alektor-diy/keyboard/temp/02.jpg

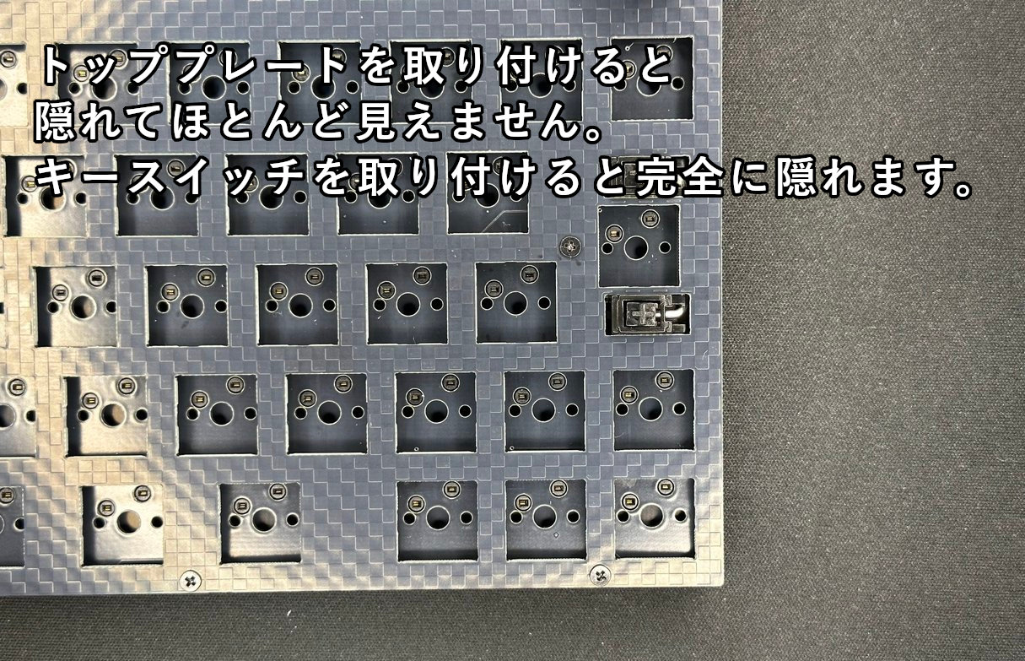
temp/02.jpg
