alektor-diy/keyboard/Maple50w/G0LdGCEbUAcLgUl.jpg

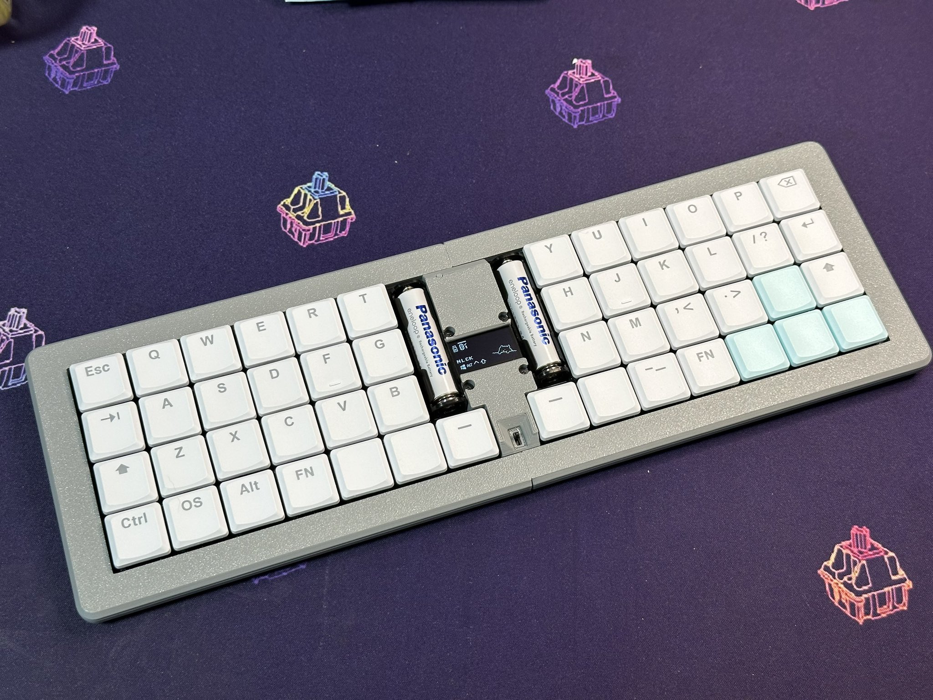
Maple50w/G0LdGCEbUAcLgUl.jpg
