alektor-diy/keyboard/temp/01.jpg

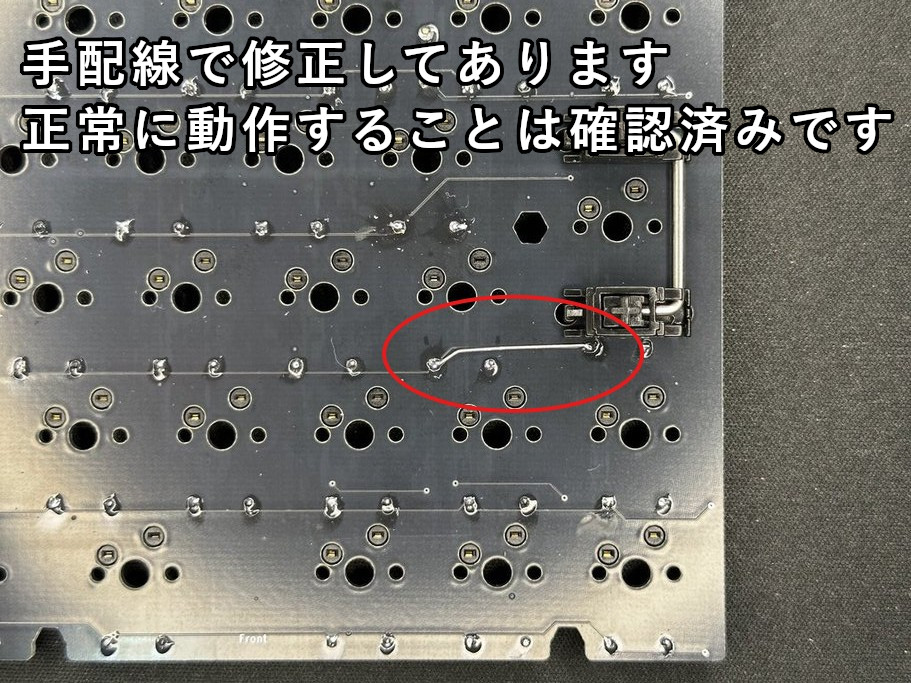
temp/01.jpg
