alektor-diy/keyboard/temp/03.jpg

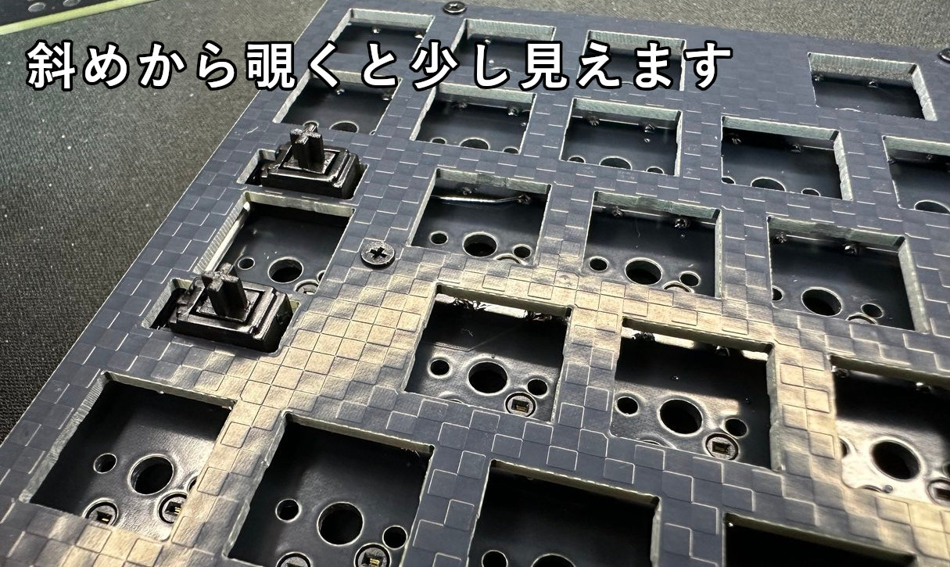
temp/03.jpg
