alektor-diy/keyboard/moon83s/pcb/Moon83s_Right_assemble.step

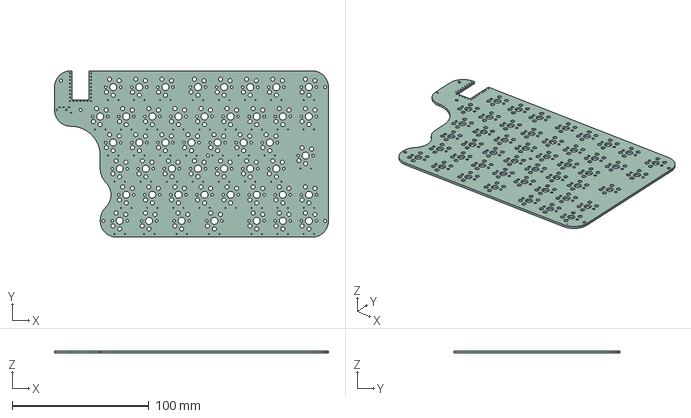
[picture p5: CAD file, 2026-04-03]
moon83s/pcb/Moon83s_Right_assemble.step
200.0 x 121.4 x 1.60 mm
