alektor-diy/keyboard/moon83s/pcb/Moon83s_Left_assemble.step

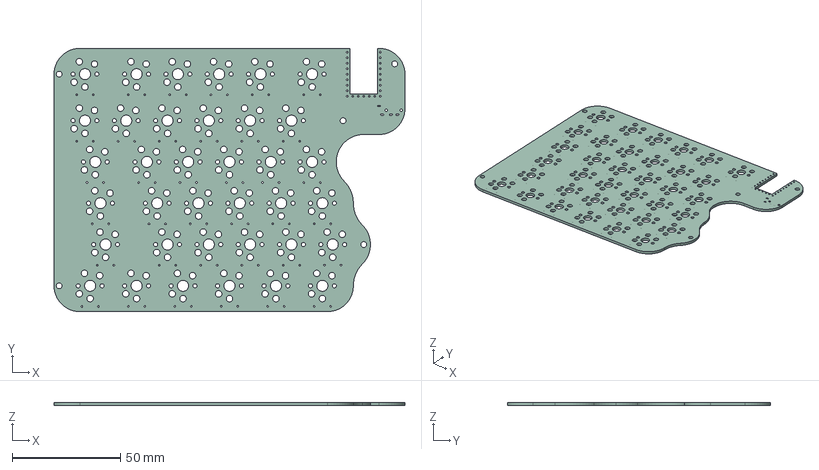
[picture p6: CAD file, 2026-04-03]
moon83s/pcb/Moon83s_Left_assemble.step
161.9 x 121.4 x 1.51 mm
