alektor-diy/keyboard/mars74g/mars74g_pcb.step

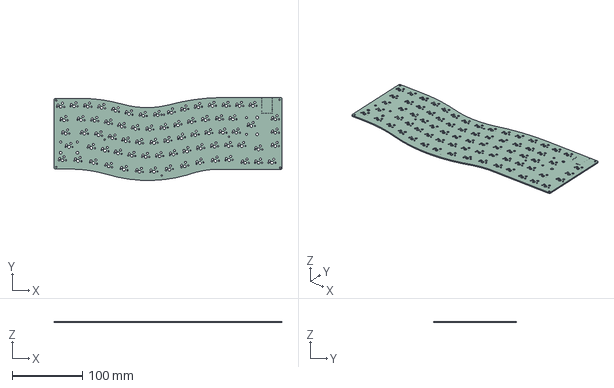
[picture p7: CAD file, 2025-04-18]
mars74g/mars74g_pcb.step
324.6 x 118.0 x 1.60 mm
