alektor-diy/keyboard/METEO2040/STEP/METEO2040.step

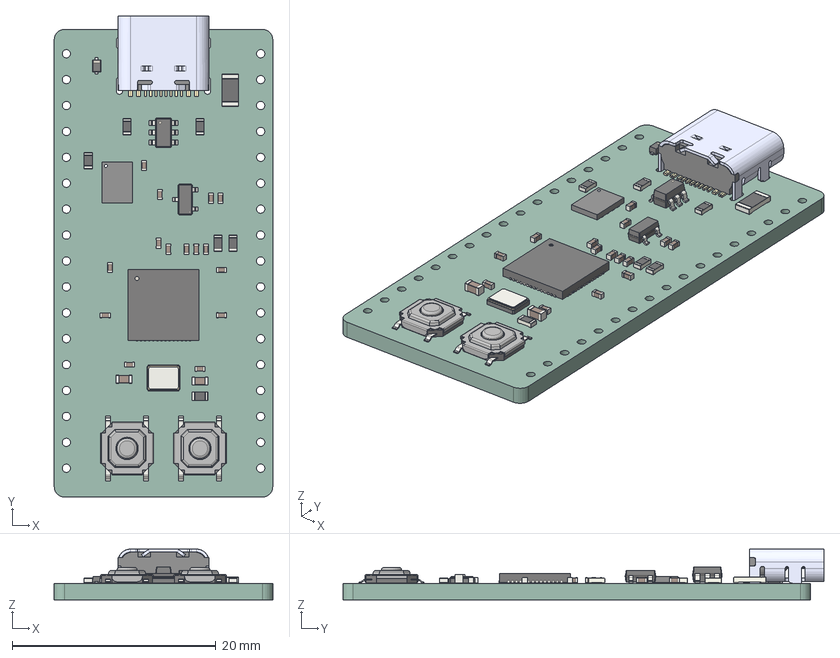
[picture p8: CAD file, 2026-06-22]
METEO2040/STEP/METEO2040.step
21.4 x 47.2 x 5.00 mm
SOT-23-3
R_0603_1608Metric x 6
C_0402_1005Metric x 15
SW_SPST_SKQG_WithStem x 2
D_SOD_523
BaseWithTopCut
TopCircle_NewBody
TYPE-C-31-M-12
Fuse_1206_3216Metric
Crystal_SMD_3225-4Pin_3.2x2.5mm
C_0603_1608Metric x 2
QFN-56-1EP_7x7mm_P0.4mm_EP3.2x3.2mm
SOT-23-6
MetD92B_PCB
