alektor-diy/keyboard/SylvaTwin/pcb/SylvaTwin_Right.step

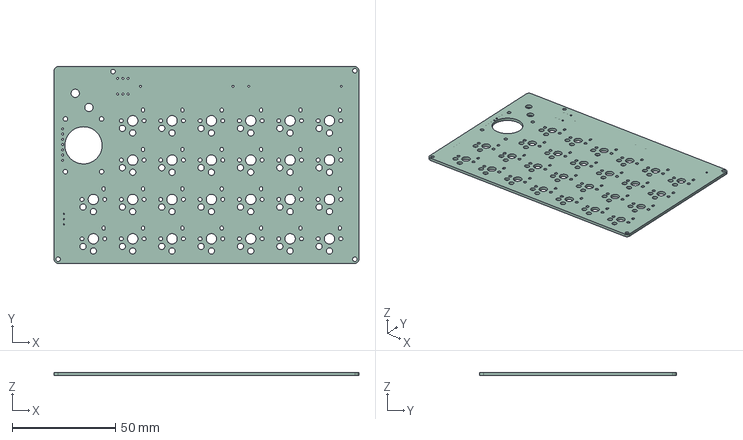
[picture p9: CAD file, 2025-12-02]
SylvaTwin/pcb/SylvaTwin_Right.step
147.6 x 95.2 x 1.60 mm
