alektor-diy/keyboard/(list of files, cad)

Other CAD files:
SylvaTwin/pcb/SylvaTwin_Left.step
