alektor-diy/keyboard/(commit log)

2024-08-05 Create JP81Fビルドガイド
2024-09-01 Upload PCB files.
    [Earth95S_left_assemble.kicad_pcb, Earth95S_left_assemble.kicad_sch, Earth95S_left_assemble.step, Earth95S_left_bottom.kicad_pcb, Earth95S_left_bottom.kicad_sch, Earth95S_left_cover.kicad_pcb, Earth95S_left_cover.kicad_sch, Earth95S_left_top.kicad_pcb]
2024-09-02 upload PCB data.
    [Earth87lcd_assemble.kicad_pcb, Earth87lcd_assemble.kicad_sch, Earth87lcd_bottom.kicad_pcb, Earth87lcd_bottom.kicad_sch, Earth87lcd_cover.kicad_pcb, Earth87lcd_cover.kicad_sch, Earth87lcd_top.kicad_pcb, Earth87lcd_top.kicad_sch]
2024-09-18 upload files of earth72alice.
    [Earth72alice_assemble.kicad_pcb, Earth72alice_assemble.kicad_sch, Earth72alice_bottom.kicad_pcb, Earth72alice_bottom.kicad_sch, Earth72alice_cover.kicad_pcb, Earth72alice_cover.kicad_sch, Earth72alice_top.kicad_pcb, Earth72alice_top.kicad_sch]
2024-10-31 create files for hawk44.
    [Hawk44_assemble.kicad_pcb, Hawk44_assemble.kicad_sch, Hawk44_bottom.kicad_pcb, Hawk44_bottom.kicad_sch, Hawk44_cover.kicad_pcb, Hawk44_cover.kicad_sch, Hawk44_top.kicad_pcb, Hawk44_top.kicad_sch]
2024-11-06 create files of insight10.
    [Insight10.kicad_pcb, Insight10.kicad_sch]
2024-11-12 upload temp files.
    [Insight10.kicad_pcb, Insight10.kicad_sch]
2024-12-02 create moon83s files.
    [Moon83s_Left_assemble.kicad_pcb, Moon83s_Left_assemble.kicad_sch, Moon83s_Right_assemble.kicad_pcb, Moon83s_Right_assemble.kicad_sch]
2025-02-20 create files of mars74g.
    [bom.csv, designators.csv, mars74g.kicad_pcb, mars74g.kicad_sch, positions.csv]
